slyker001/thermal_printer/sch/dtp.pdf

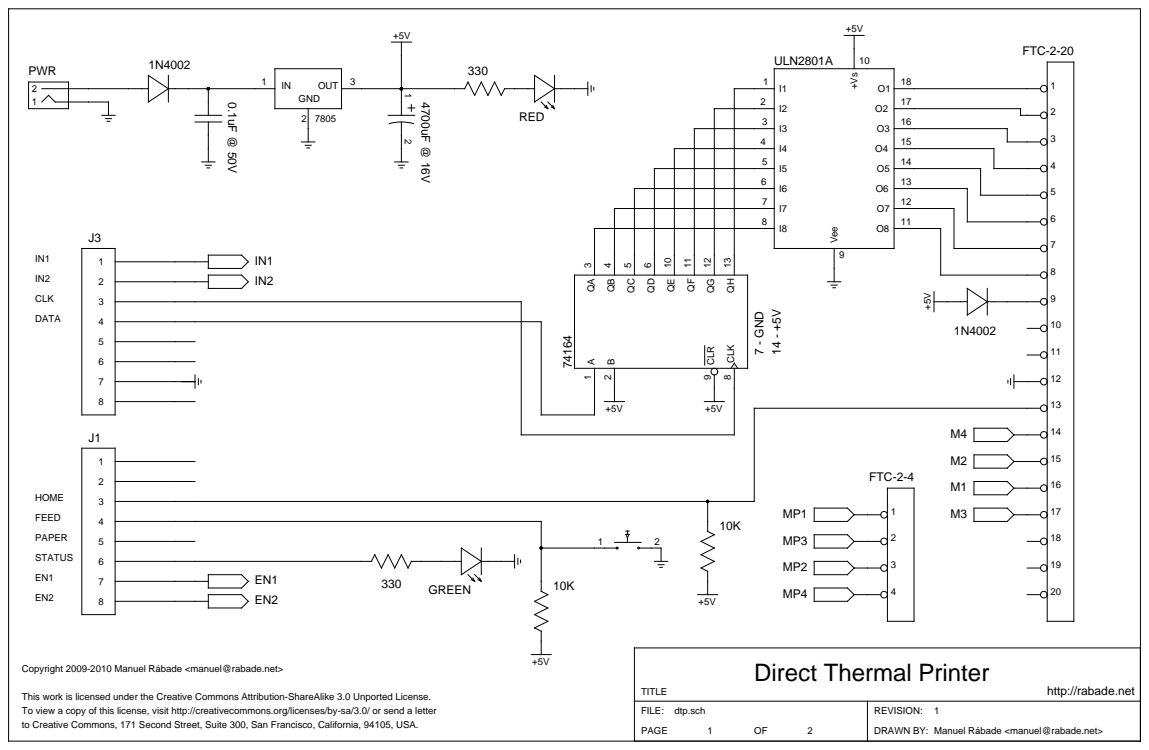
[picture p4: page 1]
PAGE; DRAWN BY:; 9 CLR 8 CLK; 7 - GND

Copyright 2009-2010 Manuel Rábade <manuel@rabade.net>

Direct Thermal Printer

This work is licensed under the Creative Commons Attribution-ShareAlike 3.0 Unported License.
To view a copy of this license, visit http://creativecommons.org/licenses/by-sa/3.0/ or send a letter
to Creative Commons, 171 Second Street, Suite 300, San Francisco, California, 94105, USA.

http://rabade.net

Manuel Rábade <manuel@rabade.net>
