slyker001/thermal_printer/sch/motors.pdf

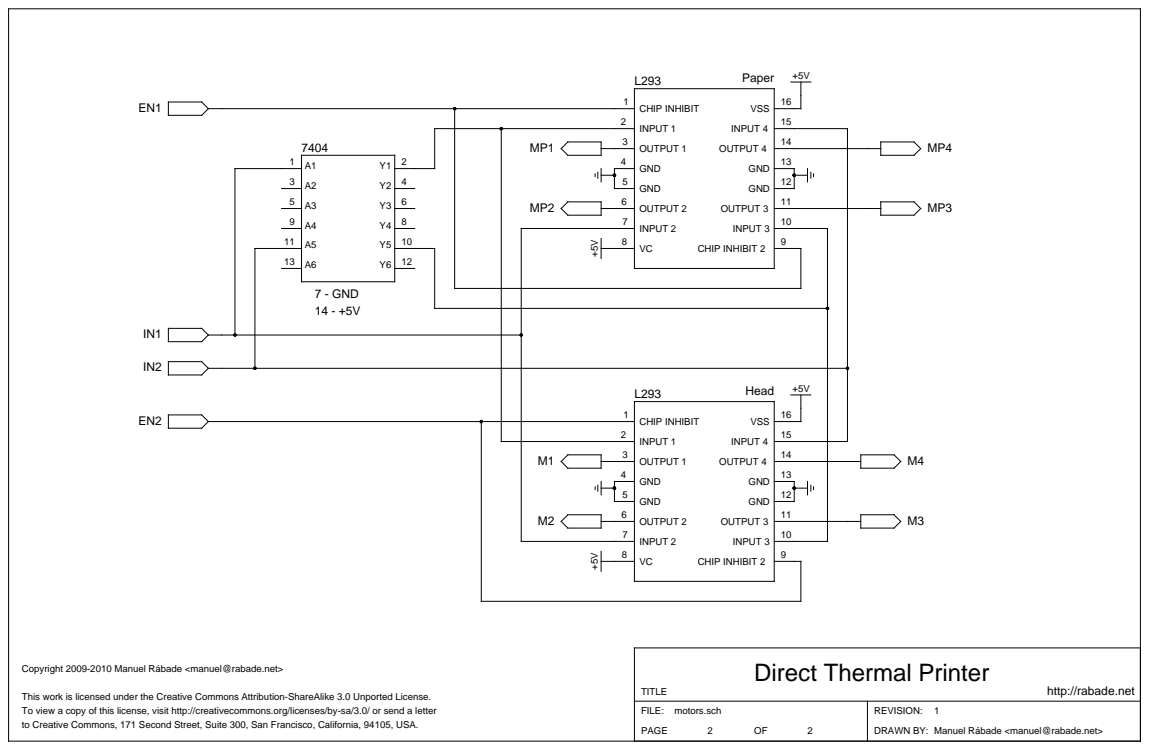
[picture p5: page 1]
PAGE; DRAWN BY:; CHIP INHIBIT 1; INPUT 1 2; OUTPUT 1 3; GND 4; GND 5; OUTPUT 2 6; INPUT 2 7; INPUT 4; OUTPUT 4; OUTPUT 3; INPUT 3; CHIP INHIBIT 2; +5V +5V 7 - GND 14 - +5V

Copyright 2009-2010 Manuel Rábade <manuel@rabade.net>

Direct Thermal Printer

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

http://rabade.net

Manuel Rábade <manuel@rabade.net>
